matthew-wolf-n4mtt/audio-switch/hardware/mark-2b/tools/Pot-vol-drop.ods

Vin | Rin | Vout | V+ | V- |  | Vin | Rin | Vout | V+ |  | Drop V+ Side |  |  |  |  |  |  |  |  | Drop V- Side
2.2248 | 2200 | 0.0967304348 | 0.0483652174 | -0.0483652174 |  | 15 | 1000 | 6 | 3
Rg | 2300 | 0.0927 | 0.04635 | -0.04635 |  |  | 1500 | 7.5 | 3.75 |  | Add res between V+ and pot (Rpn) |  |  |  |  |  |  |  |  | Add res between V- and pot (Rpn)
1.00E+002 | 2400 | 0.088992 | 0.044496 | -0.044496 |  |  | 2000 | 8.5714285714 | 4.2857142857 |  | (V+) + abs(V-)/(POT_total) + Rp = Irs (current through series Res) |  |  |  |  |  |  |  |  | (V+) + abs(V-)/(POT_total) + Rn = Irs (current through series Res)
 | 2420 | 0.0882857143 | 0.0441428571 | -0.0441428571 |  |  | 2500 | 9.375 | 4.6875
 | 2500 | 0.0855692308 | 0.0427846154 | -0.0427846154 |  |  | 3000 | 10 | 5 |  | Irs * Rpn = Vdrop |  |  |  |  |  |  |  |  | Irs * Rpn = Vdrop
 | 2347 | 0.0909194933 | 0.0454597466 | -0.0454597466 |  |  | 3500 | 10.5 | 5.25
 | 2270 | 0.0938734177 | 0.0469367089 | -0.0469367089 |  |  | 4000 | 10.9090909091 | 5.4545454545 |  | (V+)- Vdrop = adj V+ |  |  |  |  |  |  |  |  | (V-) + Vdrop = adj V-
 | 33000 | 0.0067214502 | 0.0033607251 | -0.0033607251 |  |  | 4500 | 11.25 | 5.625
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
