matthew-wolf-n4mtt/audio-switch/hardware/mark-2b/tools/Pot-vol-out.ods

 | https://www.maximintegrated.com/en/app-notes/index.mvp/id/4288
Vh | 2.2448
Vl | -2.2448
Steps | 256
Vstep | 0.0176062745 |  | Vt= Vh – Vl / (steps-1)
Steps | Wiper Vol | Volt 23:1 Div | THAT2180 dB | Vout Ratio
0 | 2.2448 | 0.0976 | -16 | 0.1584893192
1 | 2.2271937255 | 0.0968345098 | -15.8745098039 | 0.1607957293
2 | 2.209587451 | 0.0960690196 | -15.7490196078 | 0.1631357033
3 | 2.1919811765 | 0.0953035294 | -15.6235294118 | 0.1655097297
4 | 2.174374902 | 0.0945380392 | -15.4980392157 | 0.167918304
5 | 2.1567686275 | 0.093772549 | -15.3725490196 | 0.170361929
6 | 2.1391623529 | 0.0930070588 | -15.2470588235 | 0.1728411148
7 | 2.1215560784 | 0.0922415686 | -15.1215686275 | 0.1753563789
8 | 2.1039498039 | 0.0914760784 | -14.9960784314 | 0.1779082462
9 | 2.0863435294 | 0.0907105882 | -14.8705882353 | 0.1804972495
10 | 2.0687372549 | 0.089945098 | -14.7450980392 | 0.1831239291
11 | 2.0511309804 | 0.0891796078 | -14.6196078431 | 0.1857888334
12 | 2.0335247059 | 0.0884141176 | -14.4941176471 | 0.1884925187
13 | 2.0159184314 | 0.0876486275 | -14.368627451 | 0.1912355492
14 | 1.9983121569 | 0.0868831373 | -14.2431372549 | 0.1940184976
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
