matthew-wolf-n4mtt/audio-switch/hardware/mark-2c/dac-desgin-validation/DAC-stuff.ods

AD5337 vout
Vref |  | DAC code | Vout | Scaled by Vdiv | Voff | dB offset v | Round
5 | 0 | 0 | 0.000000 | 0.000000 | 0.168000 | 27.540984 | 27.5 | 27.0 |  |  |  | -0.61 | 0.16775 |  |  | Voff | -0.61 | -0.000003427
R1 | 1 | 1 | 0.019608 | 0.003057 | 0.164943 | 27.039908 | 27 | 26.5
6.34E+003 | 2 | 2 | 0.039216 | 0.006113 | 0.161887 | 26.538832 | 26.5 |  |  |  |  |  | V: | -0.16775 | 0.61
R2 | 3 | 3 | 0.058824 | 0.009170 | 0.158830 | 26.037757 | 26 |  |  |  |  |  | dB: | 27.5 | -100
6.49E+003 | 4 | 4 | 0.078431 | 0.012226 | 0.155774 | 25.536681 | 25.5
R3 | 5 | 5 | 0.098039 | 0.015283 | 0.152717 | 25.035605 | 25 |  |  |  |  |  | V: | 0.16513 | -0.60795
2.00E+003 | 6 | 6 | 0.117647 | 0.018339 | 0.149661 | 24.534530 | 24.5 |  |  |  |  |  | dB: | 27.0704918033 | -99.6639344262
Roffset | 7 | 7 | 0.137255 | 0.021396 | 0.146604 | 24.033454 | 24
1.78E+005 | 8 | 8 | 0.156863 | 0.024452 | 0.143548 | 23.532378 | 23.5 |  |  | Low | mid | high
Voffset | 9 | 9 | 0.176471 | 0.027509 | 0.140491 | 23.031302 | 23 |  | 0 | 0.164898 | -0.22044 | -0.60847
0.168 | A | 10 | 0.196078 | 0.030566 | 0.137434 | 22.530227 | 22.5 |  | 1 | 0.166065 | -0.22045 | -0.60696
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
