matthew-wolf-n4mtt/audio-switch/hardware/mark-2c/add-lpf-vga-to-audio-switch-0_2.pdf

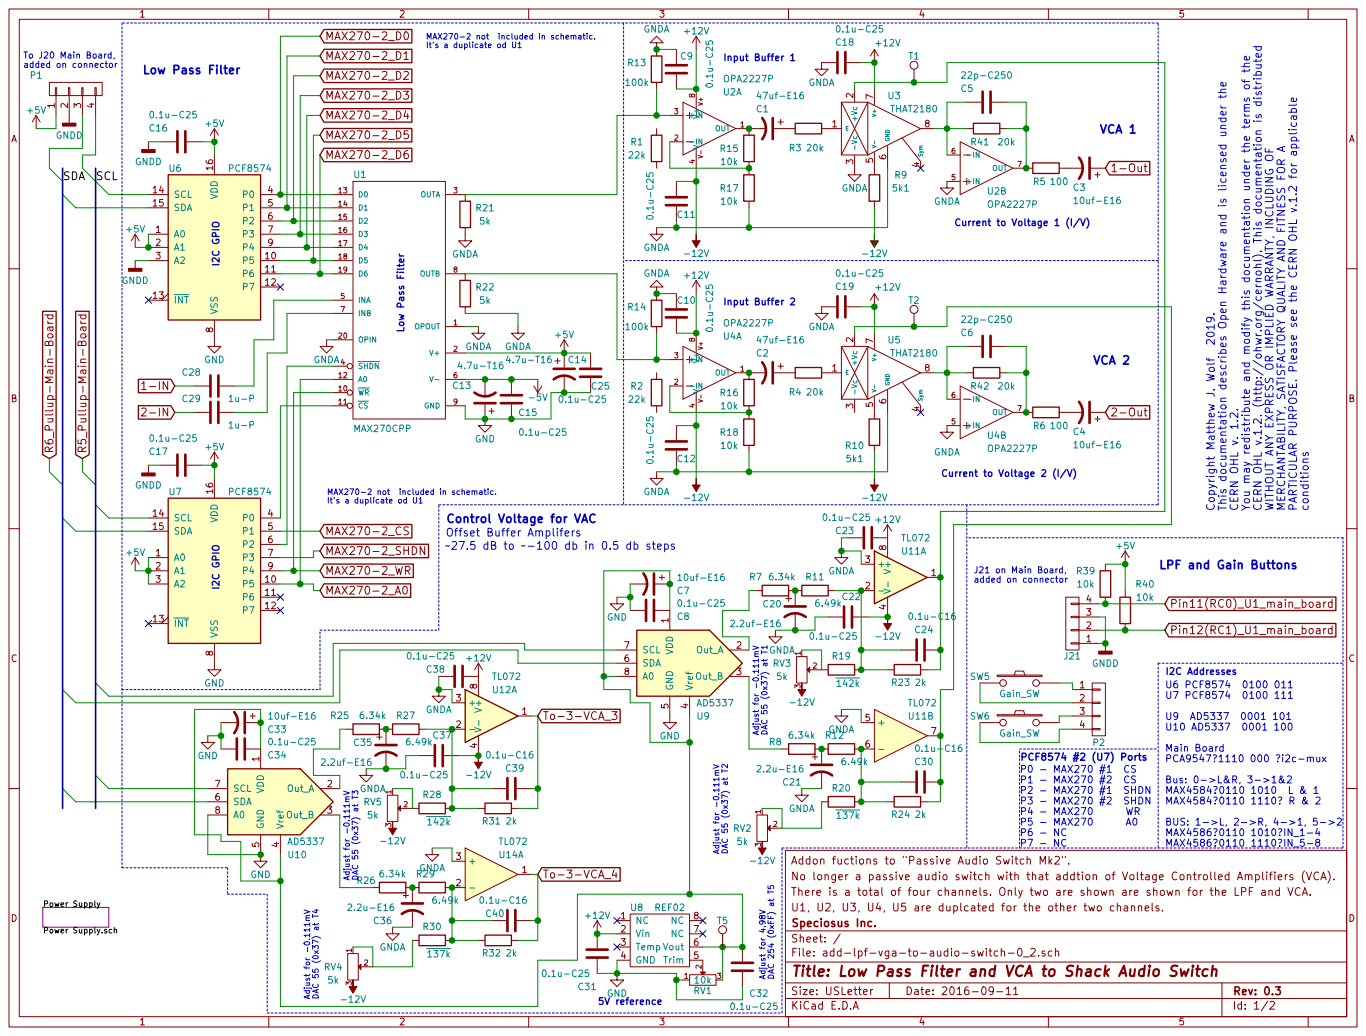
[picture p1: page 1]

T2T1 MAX270-2 not included in schematic.

4 P1 To J20 Main Board, added on connector +5V GNDD

VCA 2 Low Pass FilterI2C GPIO I2C GPIO

Control Voltage for VAC
Offset Buffer Amplifers
27.5 dB to -100 db in 0.5 db steps

J21 on Main Board, added on connector

No longer a passive audio switch with that addtion of Voltage Controlled Amplifiers (VCA). Addon fuctions to "Passive Audio Switch Mk2".

There is a total of four channels. Only two are shown are shown for the LPF and VCA.
U1, U2, U3, U4, U5 are duplcated for the other two channels.
D Date: 2016-09-11 KiCad E.D.A
File: add-lpf-vga-to-audio-switch-0_2.sch Sheet: / Speciosus Inc.

Id: 1/2 Title: Low Pass Filter and VCA to Shack Audio Switch

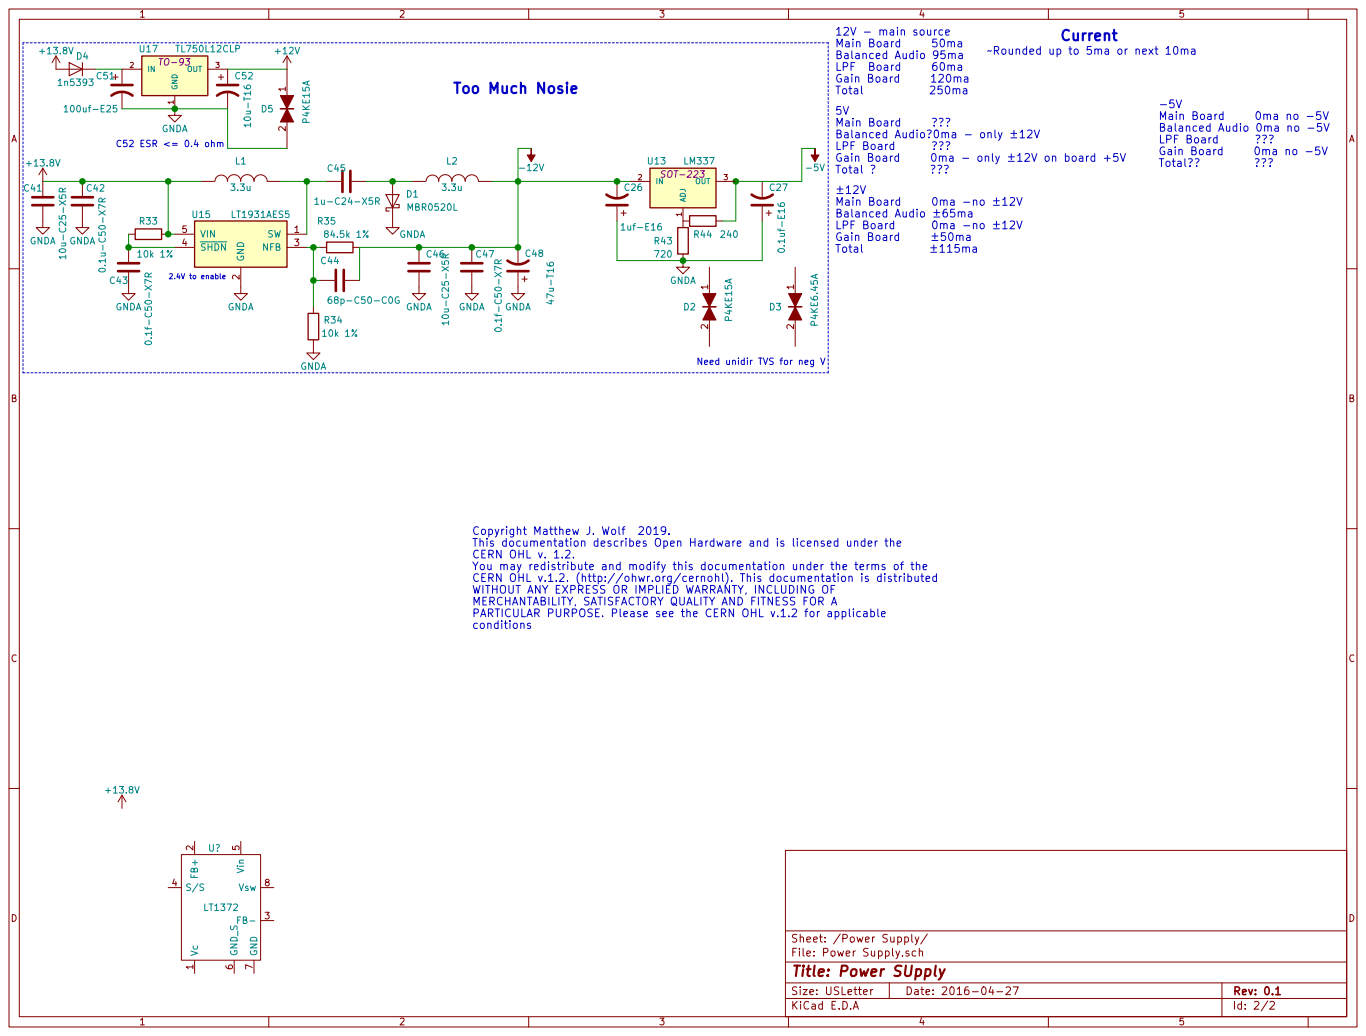
[picture p2: page 2]

1 2 D2 P4KE15A1 2 D3 P4KE6.45A2.4V to enable Current 5VMain Board ??? Balanced Audio 0ma - only ±12V

Copyright Matthew J. Wolf 2019.
This documentation describes Open Hardware and is licensed under the CERN OHL v. 1.2. You may redistribute and modify this documentation under the terms of the

CERN OHL v.1.2. (http://ohwr.org/cernohl). This documentation is distributed
WITHOUT ANY EXPRESS OR IMPLIED WARRANTY, INCLUDING OF
MERCHANTABILITY, SATISFACTORY QUALITY AND FITNESS FOR A
PARTICULAR PURPOSE. Please see the CERN OHL v.1.2 for applicable
conditions

D Date: 2016-04-27 KiCad E.D.A

Sheet: /Power Supply/
File: Power Supply.sch
Id: 2/2 Title: Power SUpply

Size: USLetter | | Rev: 0.1
