matthew-wolf-n4mtt/audio-switch/hardware/mark-2a/unbalanced to balanced line driver.pdf

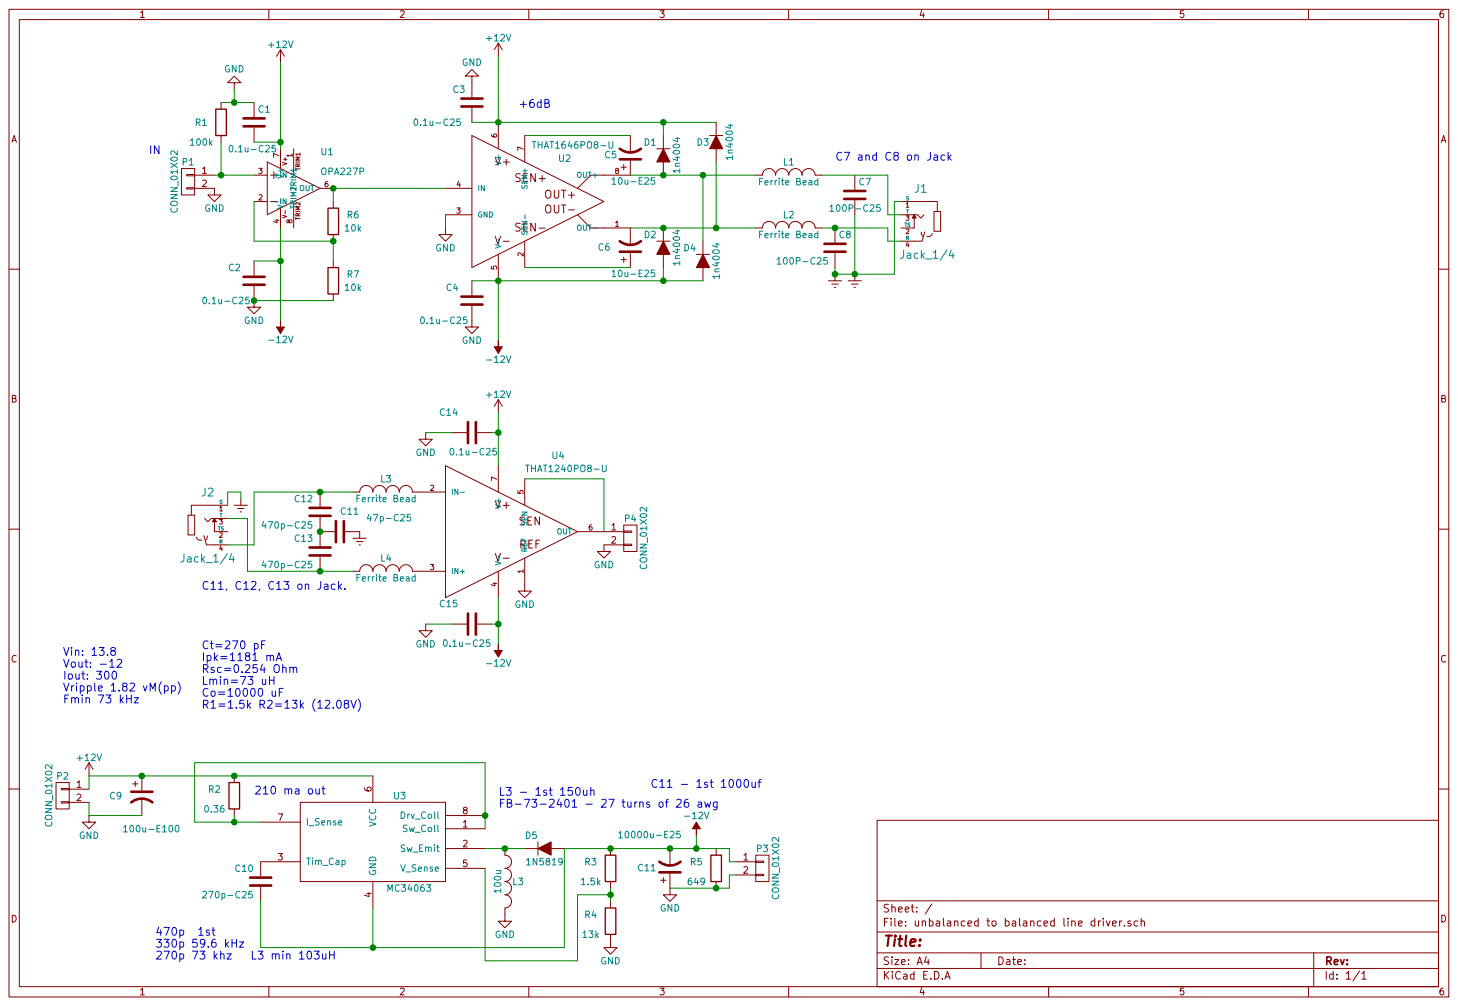
[picture p3: page 1]

L3 - 1st 150uh FB-73-2401 - 27 turns of 26 awg

Id: 1/1 Title: File: unbalanced to balanced line driver.sch Sheet: /
D Date: KiCad E.D.A
