matthew-wolf-n4mtt/audio-switch/hardware/mark-2b/add-lpf-vga-to-audio-switch.pdf

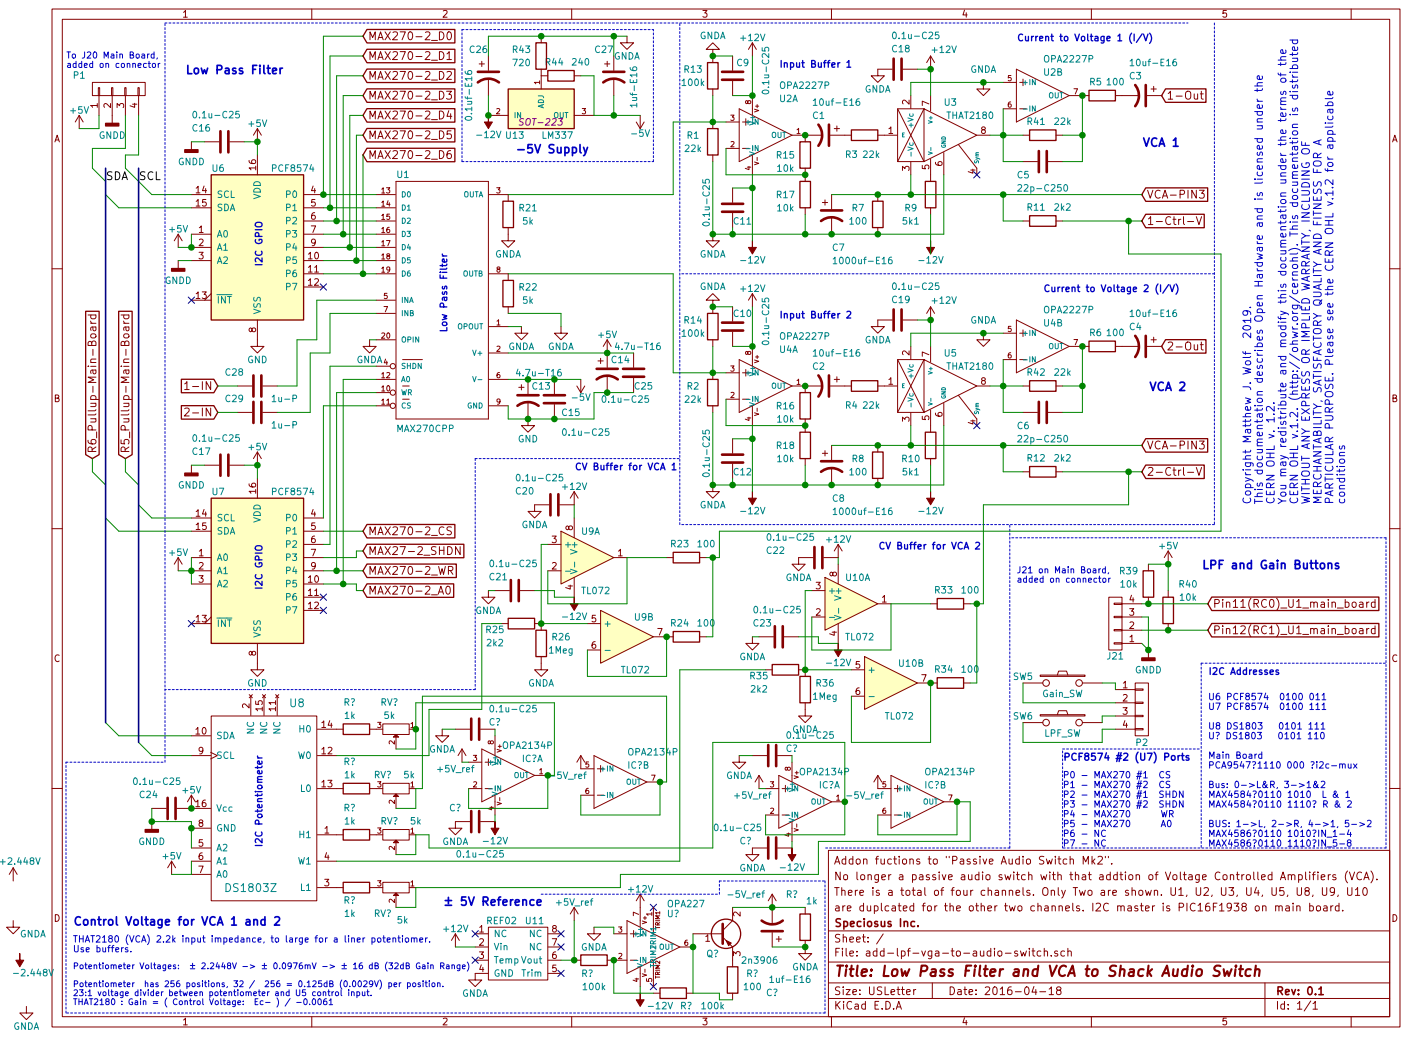
[picture p4: page 1]

4 P1 To J20 Main Board, added on connector +5V GNDD

J21 on Main Board, added on connector

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

There is a total of four channels. Only Two are shown. U1, U2, U3, U4, U5, U8, U9, U10
are duplcated for the other two channels. I2C master is PIC16F1938 on main board.
D Date: 2016-04-18 KiCad E.D.A
File: add-lpf-vga-to-audio-switch.sch Sheet: / Speciosus Inc.

Id: 1/1 Title: Low Pass Filter and VCA to Shack Audio Switch
