matthew-wolf-n4mtt/audio-switch/hardware/mark-3/Audio-Switch-Hardware-MK3.pdf

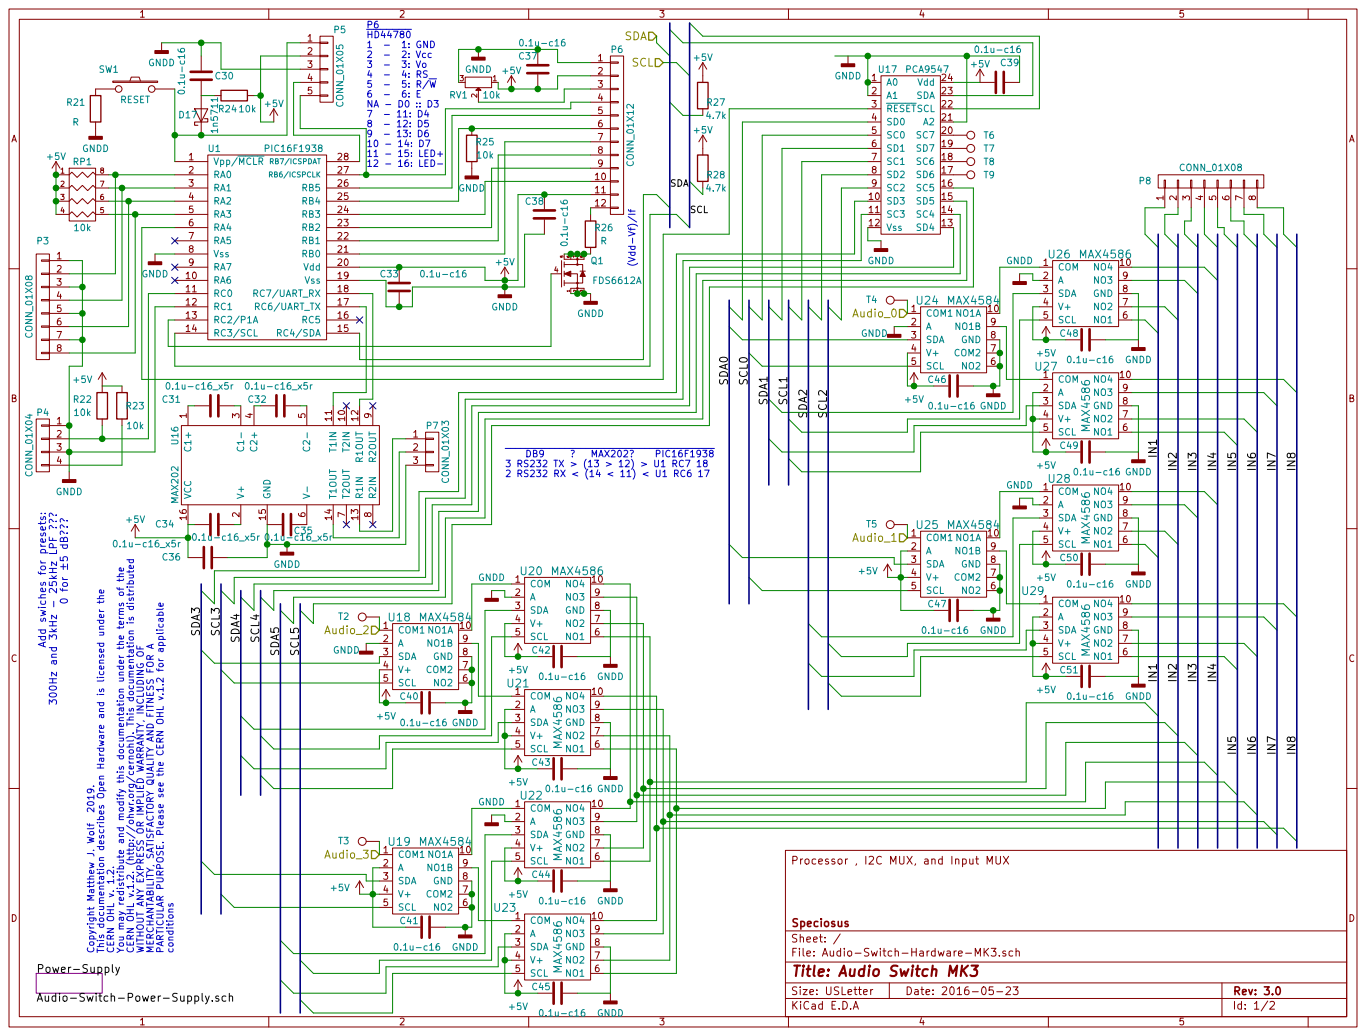
[picture p5: page 1]

SCL Copyright Matthew J. Wolf 2019. This documentation describes Open Hardware and is licensed under the CERN OHL v. 1.2. You may redistribute and modify this documentation under the terms of the CERN OHL v.1.2. (http://ohwr.org/cernohl). This documentation is distributed WITHOUT ANY EXPRESS OR IMPLIED WARRANTY, INCLUDING OF MERCHANTABILITY, SATISFACTORY QUALITY AND FITNESS FOR A PARTICULAR PURPOSE. Please see the CERN OHL v.1.2 for applicable conditions

8 Q1FDS6612A GNDD Add swiches for presets: 300Hz and 3kHz - 25kHz LPF ??? 0 for ±5 dB??? R22

Processor , I2C MUX, and Input MUX

D Date: 2016-05-23 KiCad E.D.A
File: Audio-Switch-Hardware-MK3.sch Sheet: / Speciosus

Id: 1/2 Title: Audio Switch MK3

Audio-Switch-Power-Supply.sch

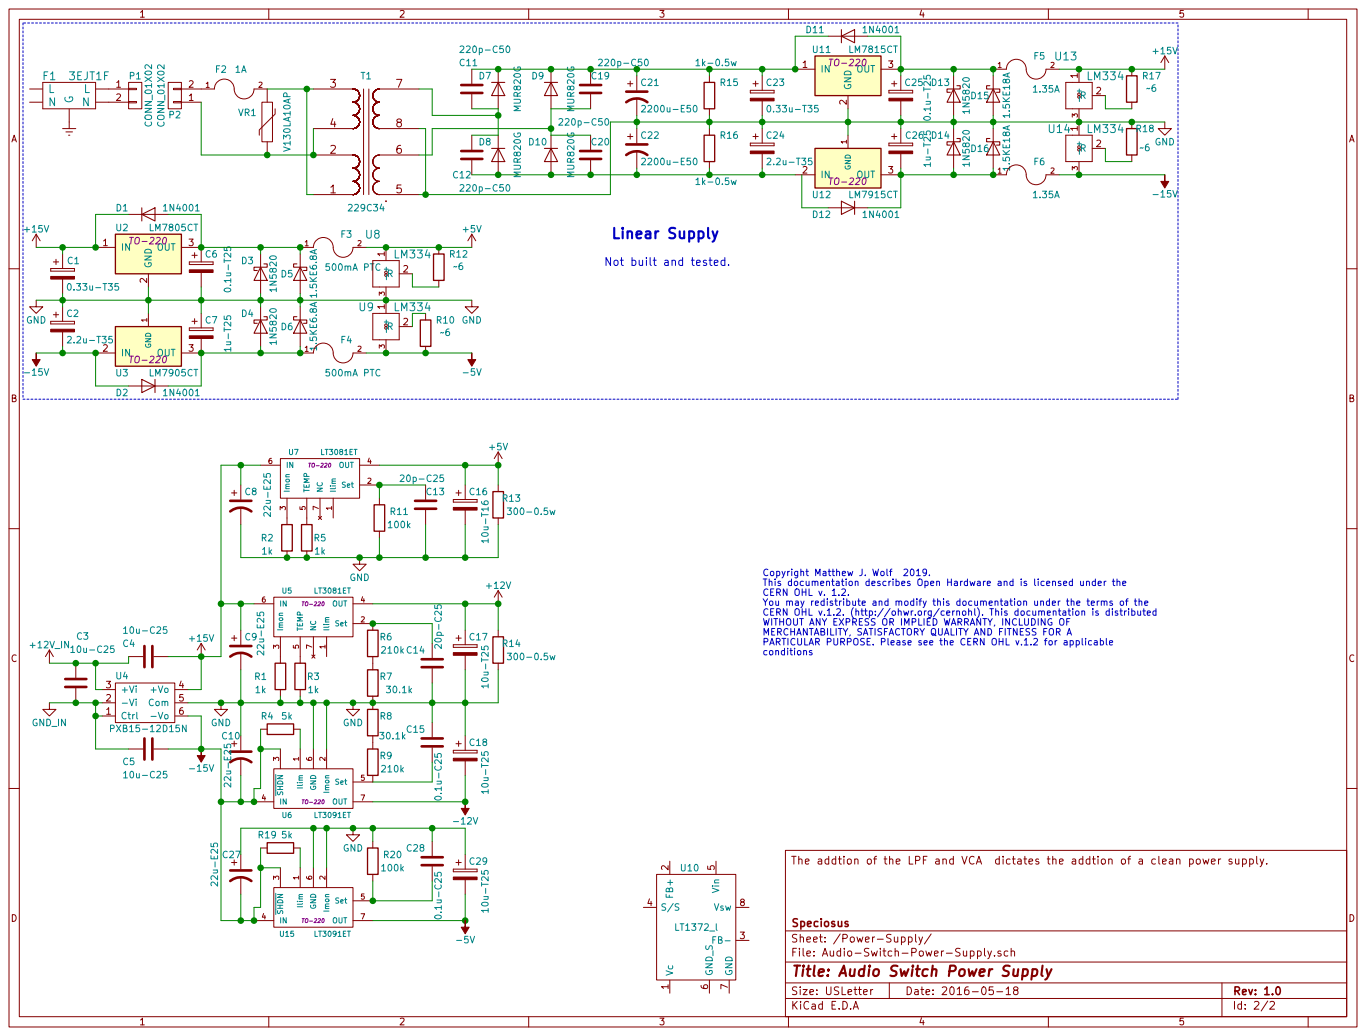
[picture p6: page 2]
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

PARTICULAR PURPOSE. Please see the CERN OHL v.1.2 for applicable
conditions

D Date: 2016-05-18 KiCad E.D.A

Speciosus
Sheet: /Power-Supply/
File: Audio-Switch-Power-Supply.sch
Id: 2/2 Title: Audio Switch Power Supply

Size: USLetter | | Rev: 1.0
