matthew-wolf-n4mtt/audio-switch/hardware/mark-0/audio-switch-MK0-all.pdf

PIC16F1938 | U1

U2

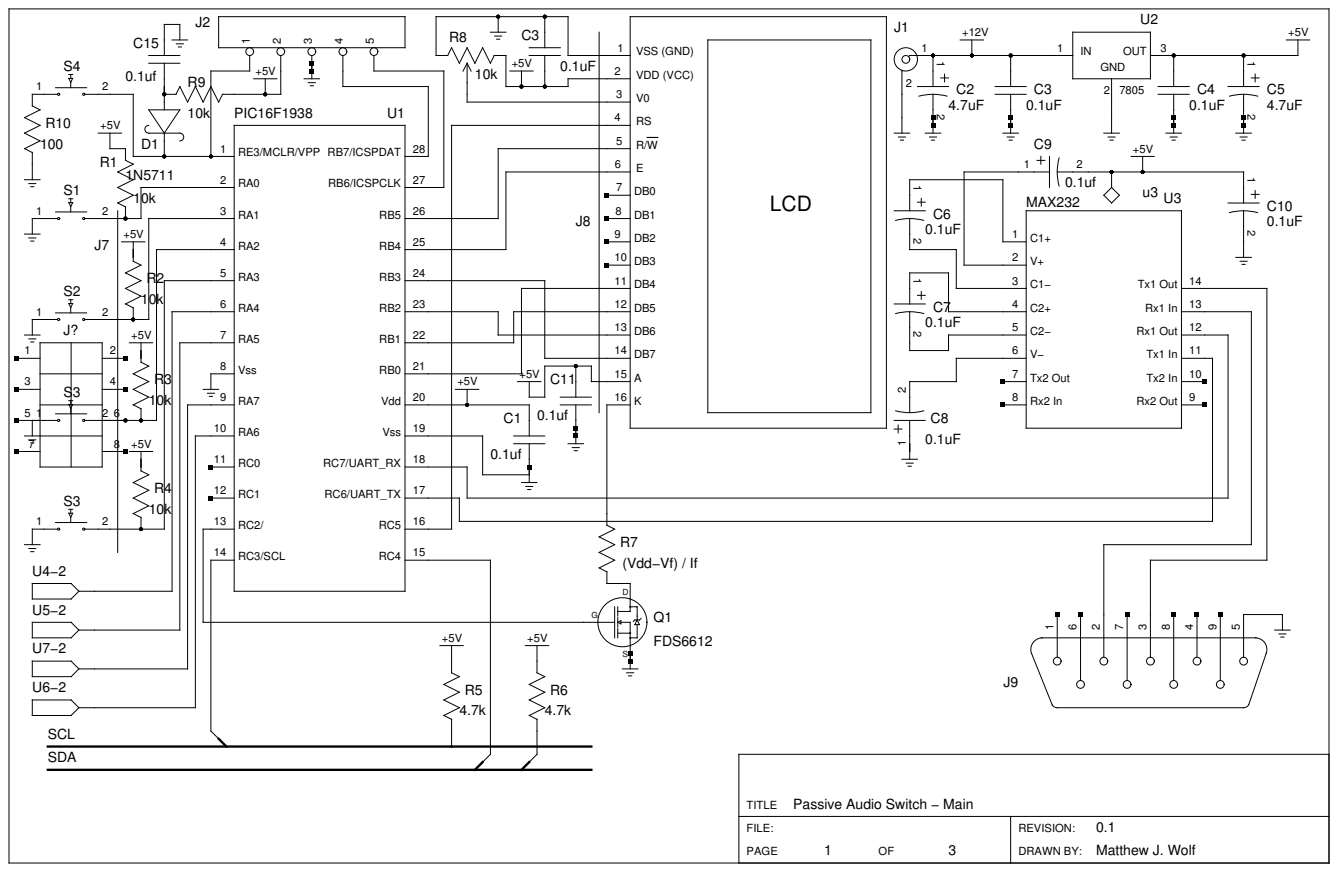
[picture p7: page 1]

Passive Audio Switch − Main

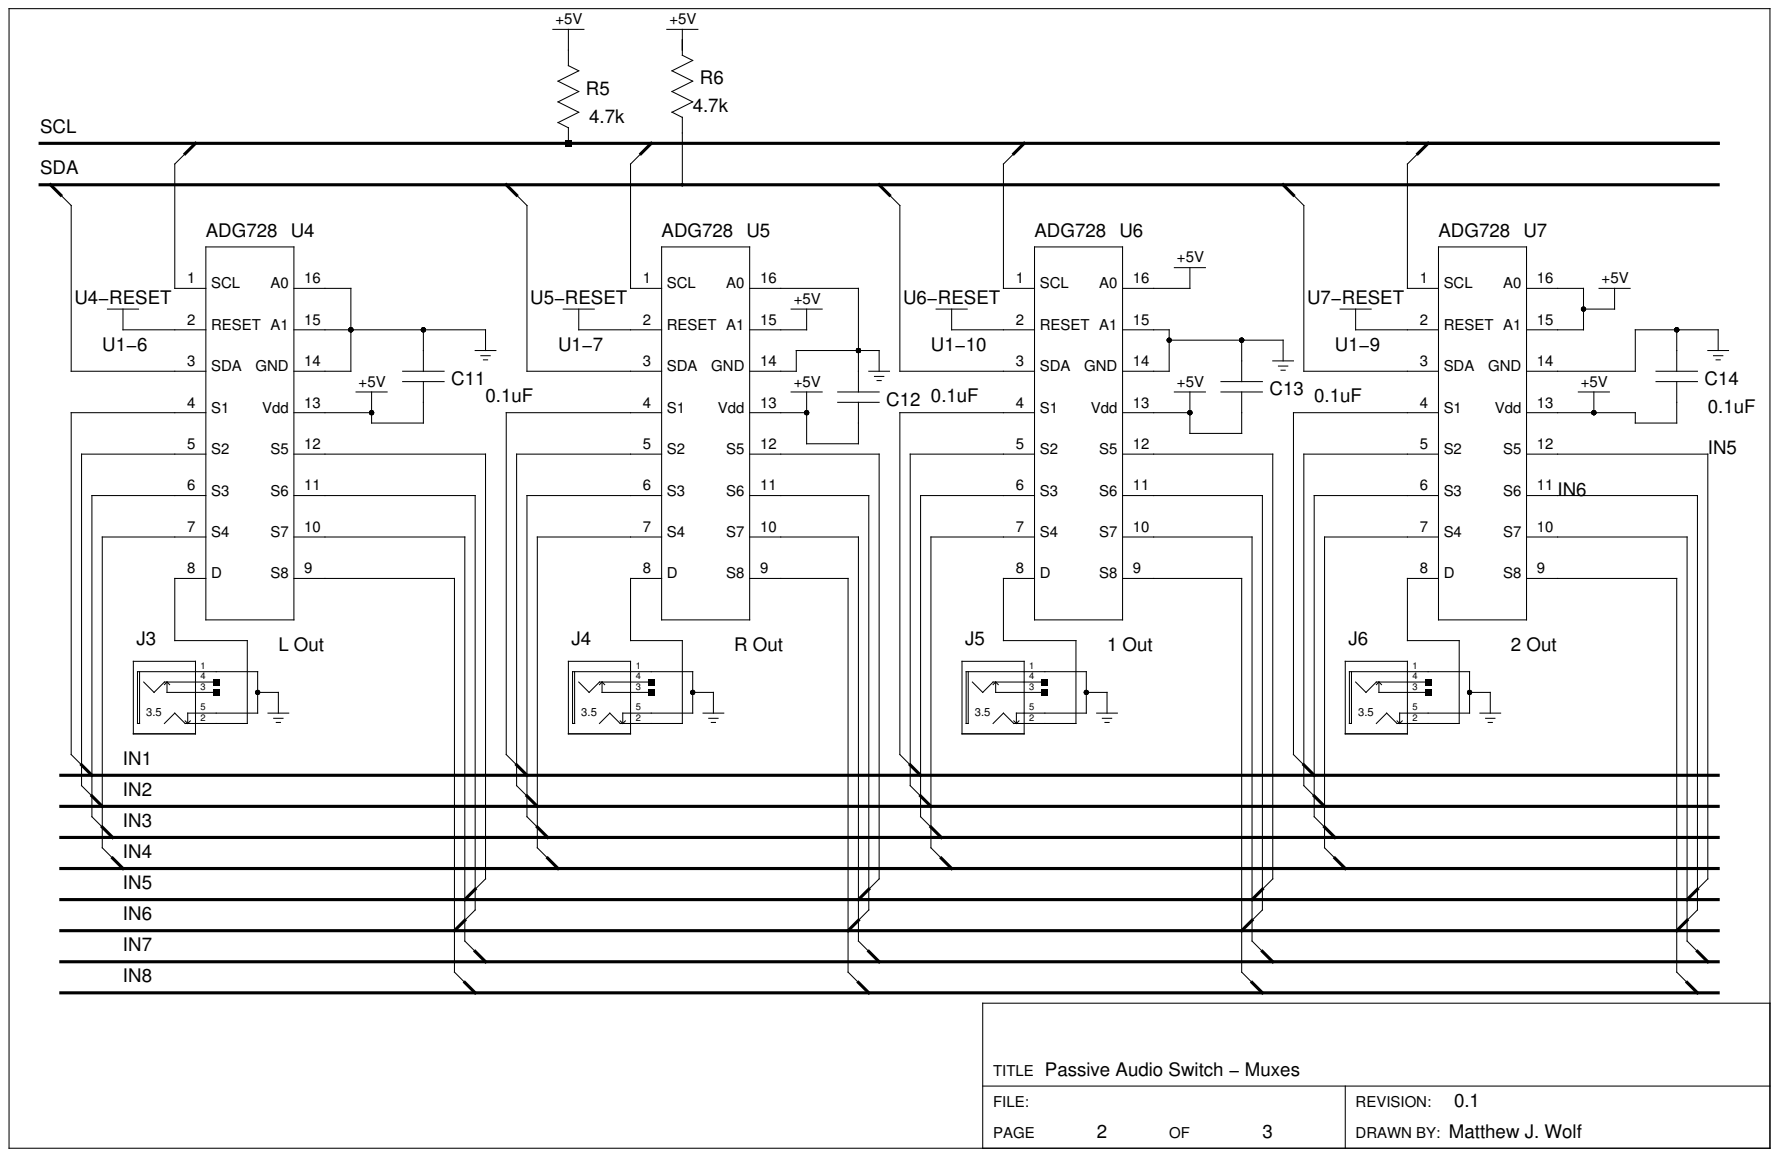
[picture p8: page 2]

Passive Audio Switch − Muxes

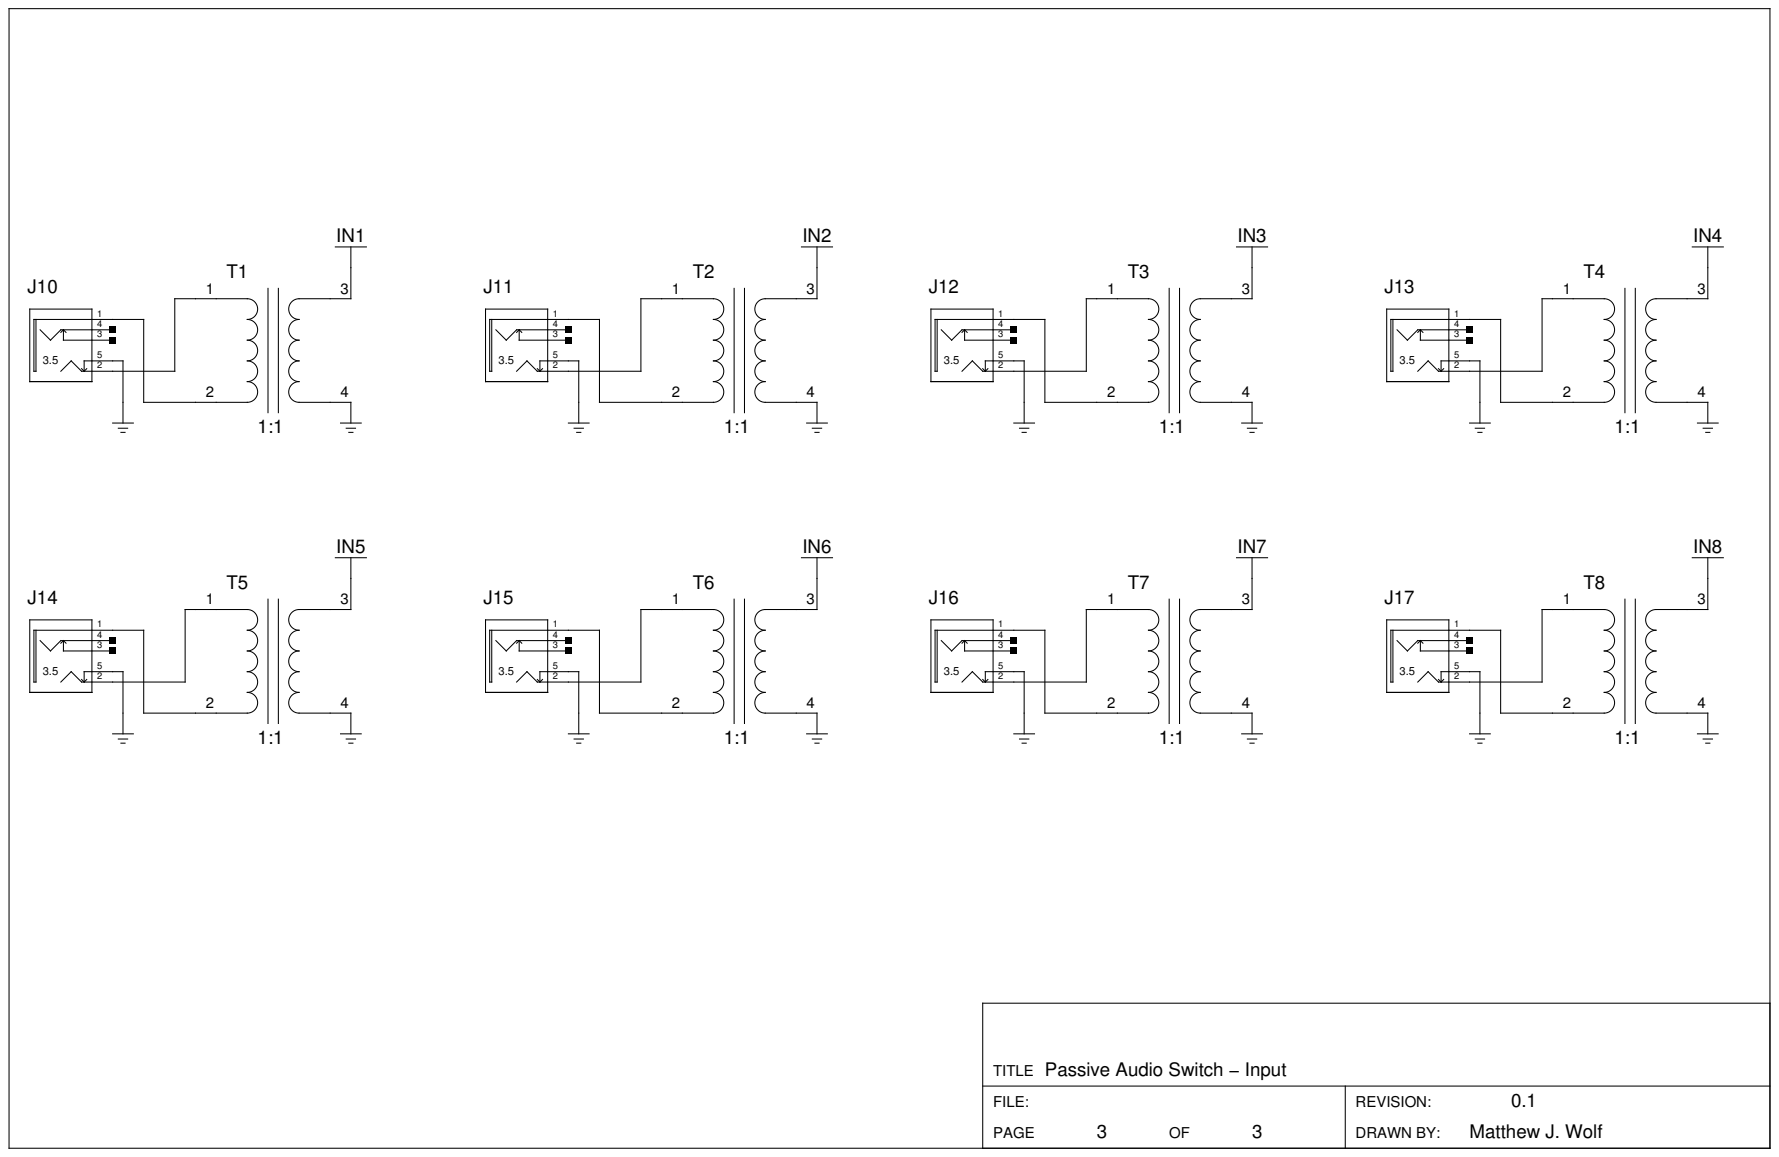
[picture p9: page 3]

Passive Audio Switch − Input
