matthew-wolf-n4mtt/audio-switch/hardware/mark-1/audio-switch-MK1-all.pdf

PIC16F1938 | U1

U2

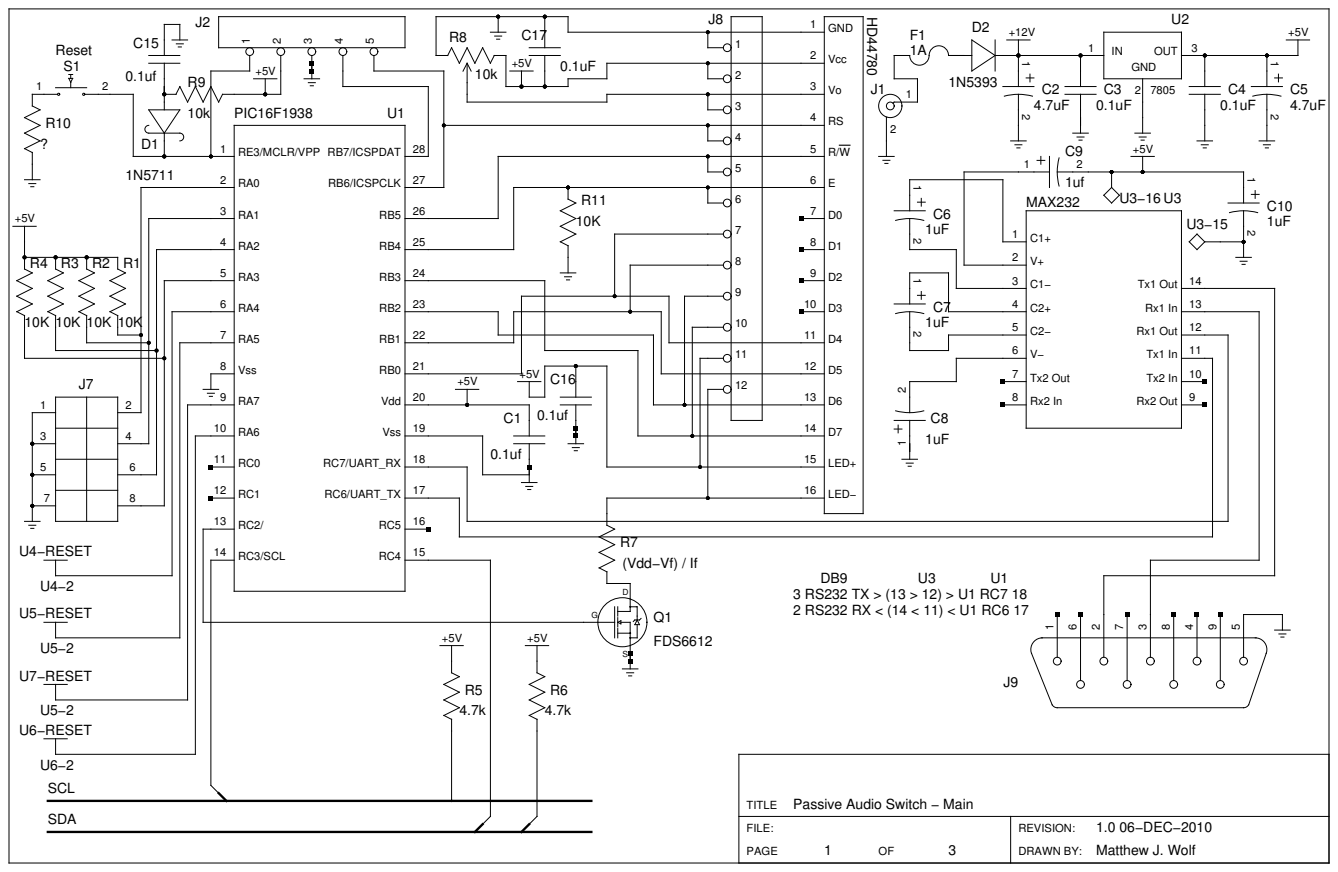
[picture p10: page 1]

Passive Audio Switch − Main


Passive Audio Switch − Muxes

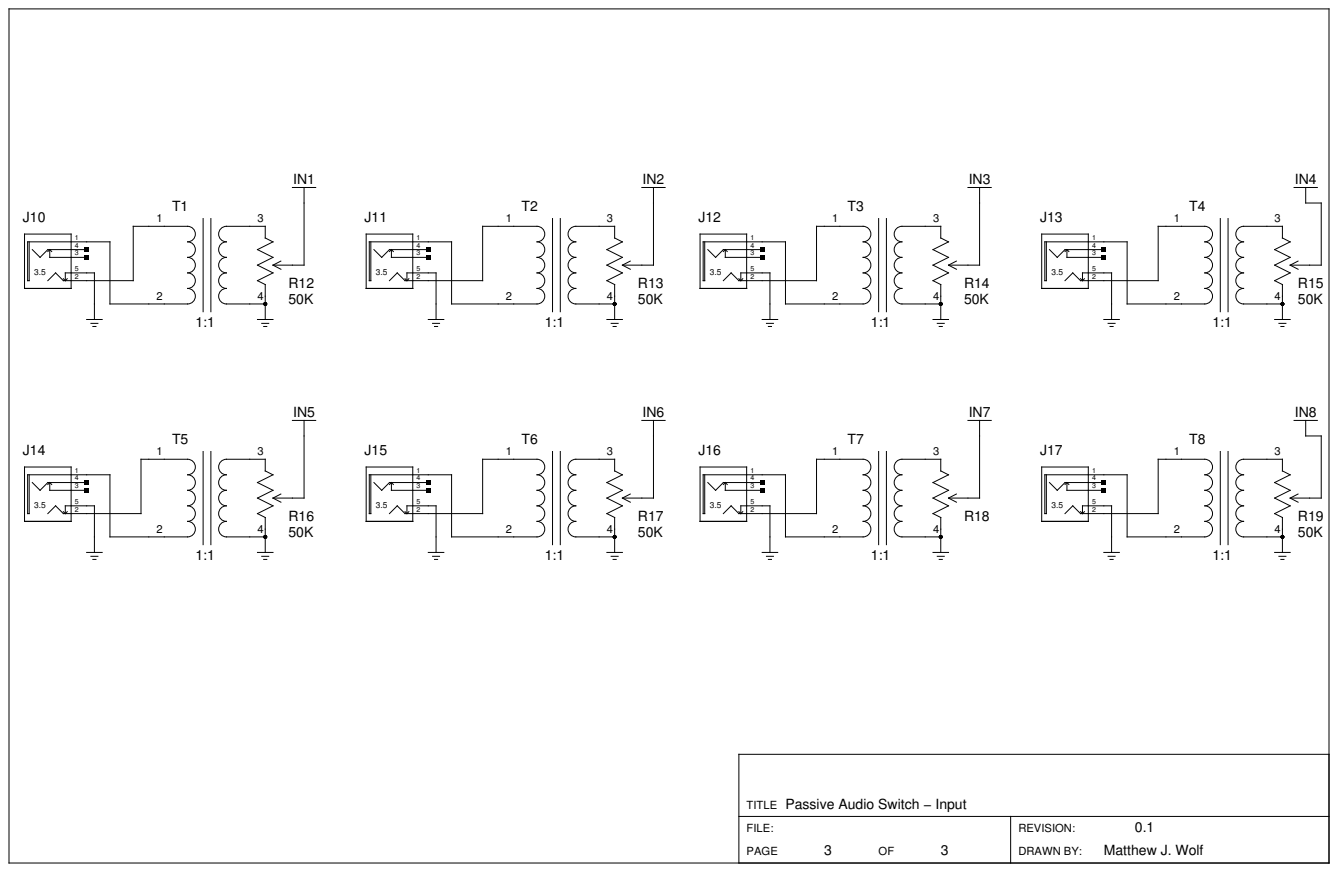
[picture p11: page 3]

Passive Audio Switch − Input
