matthew-wolf-n4mtt/audio-switch/hardware/mark-2/audio-switch-MK2-all.pdf

PIC16F1938 | U1

U2

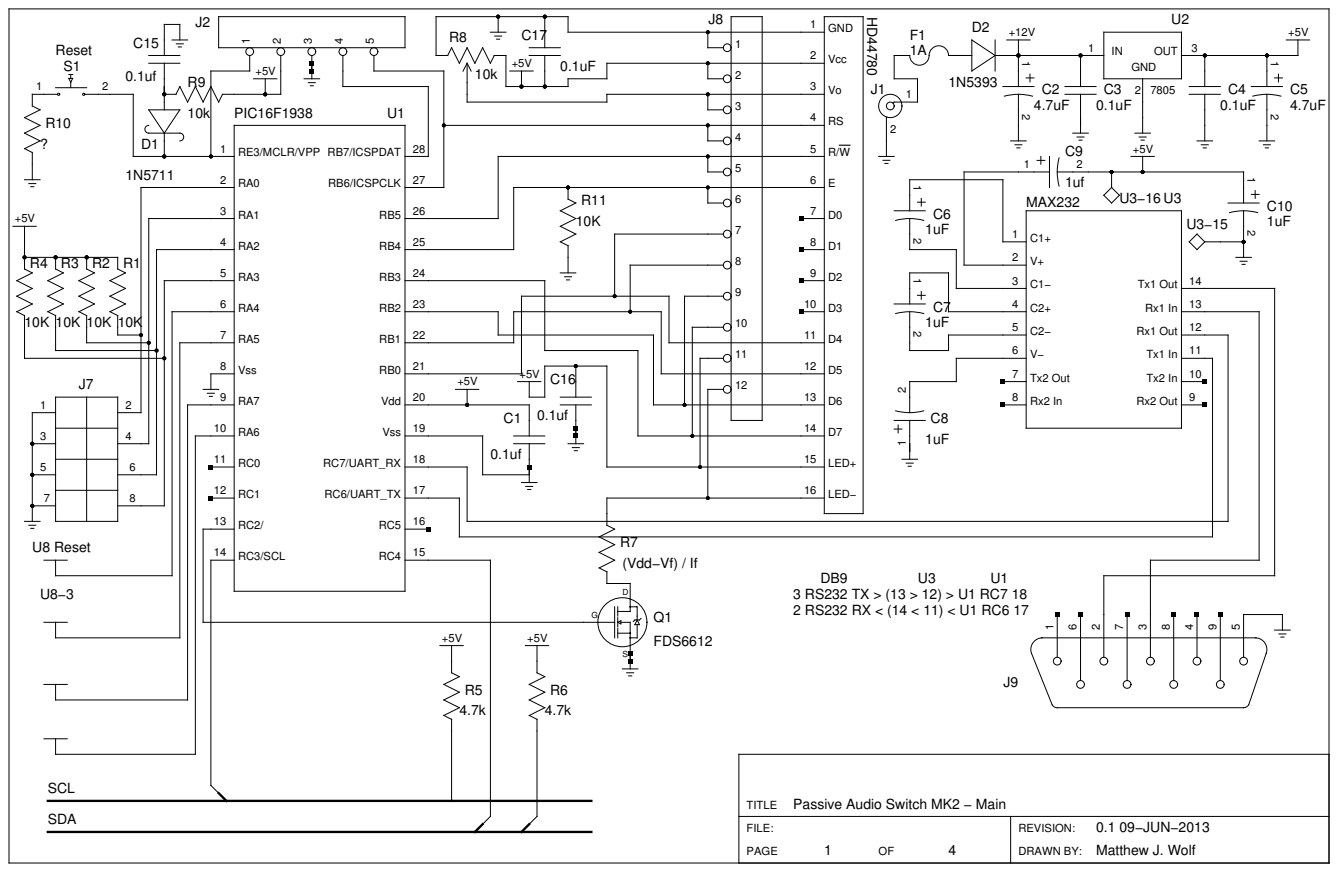
[picture p12: page 1]

Passive Audio Switch MK2 − Main

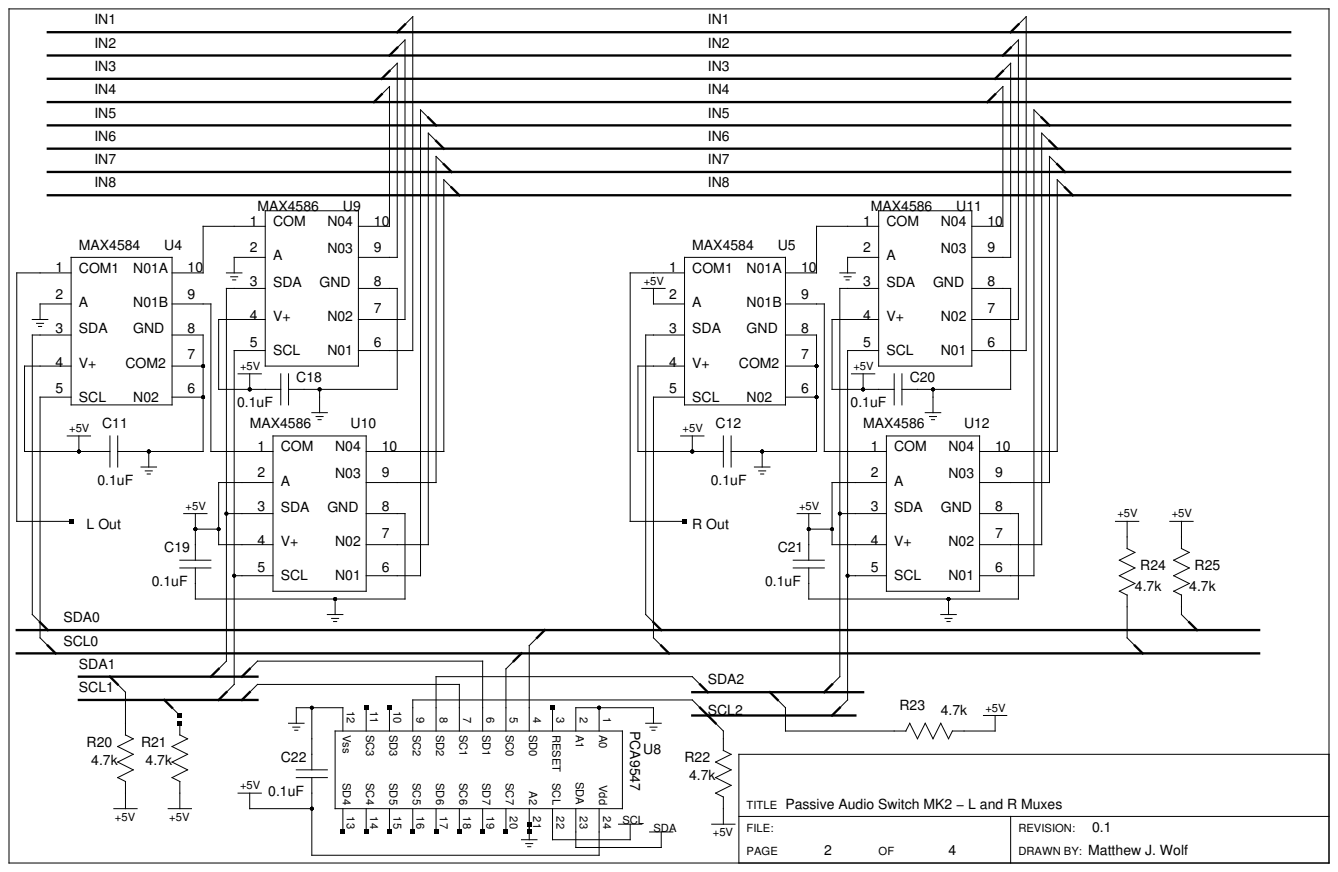
[picture p13: page 2]

Passive Audio Switch MK2 − L and R Muxes

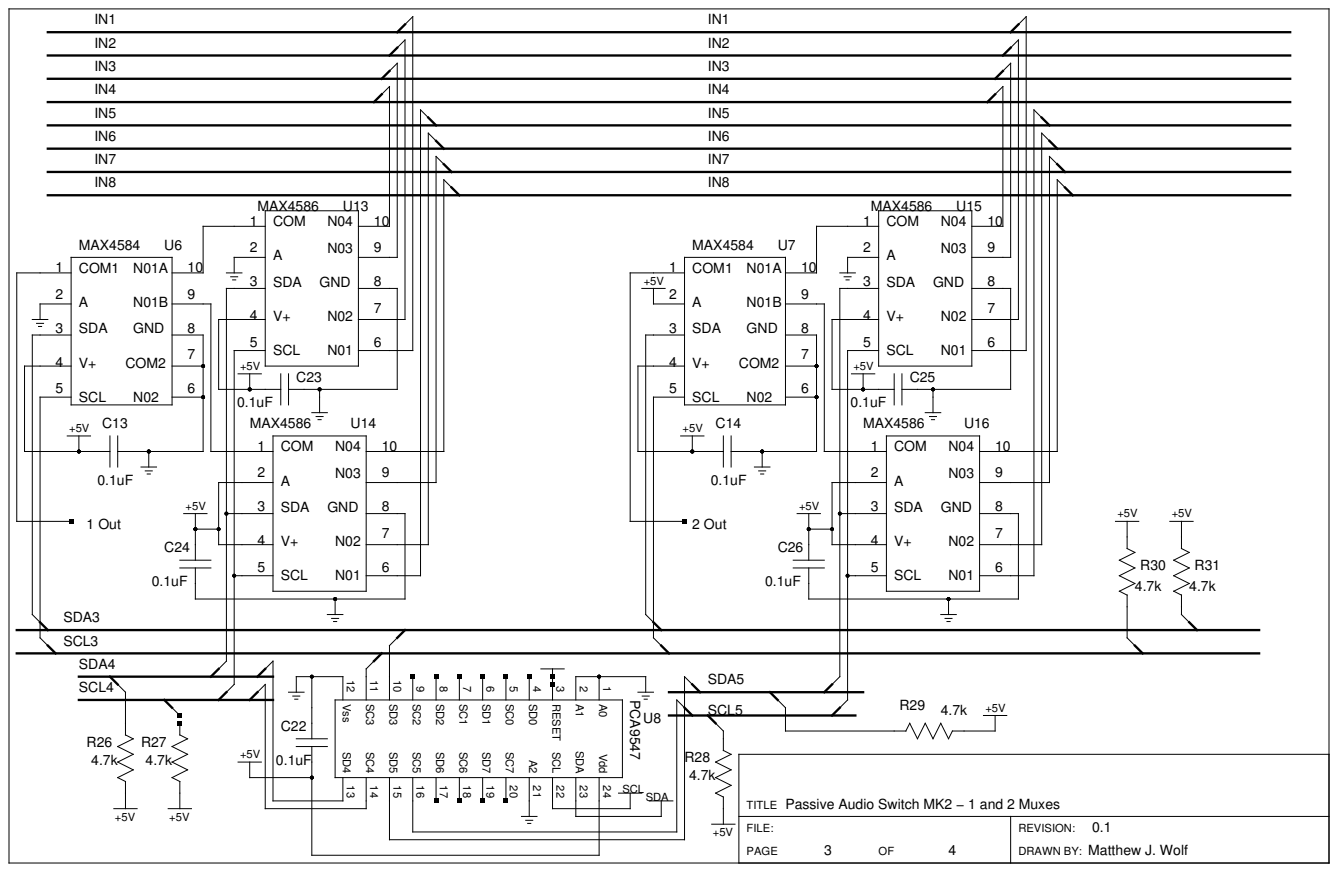
[picture p14: page 3]

Passive Audio Switch MK2 − 1 and 2 Muxes

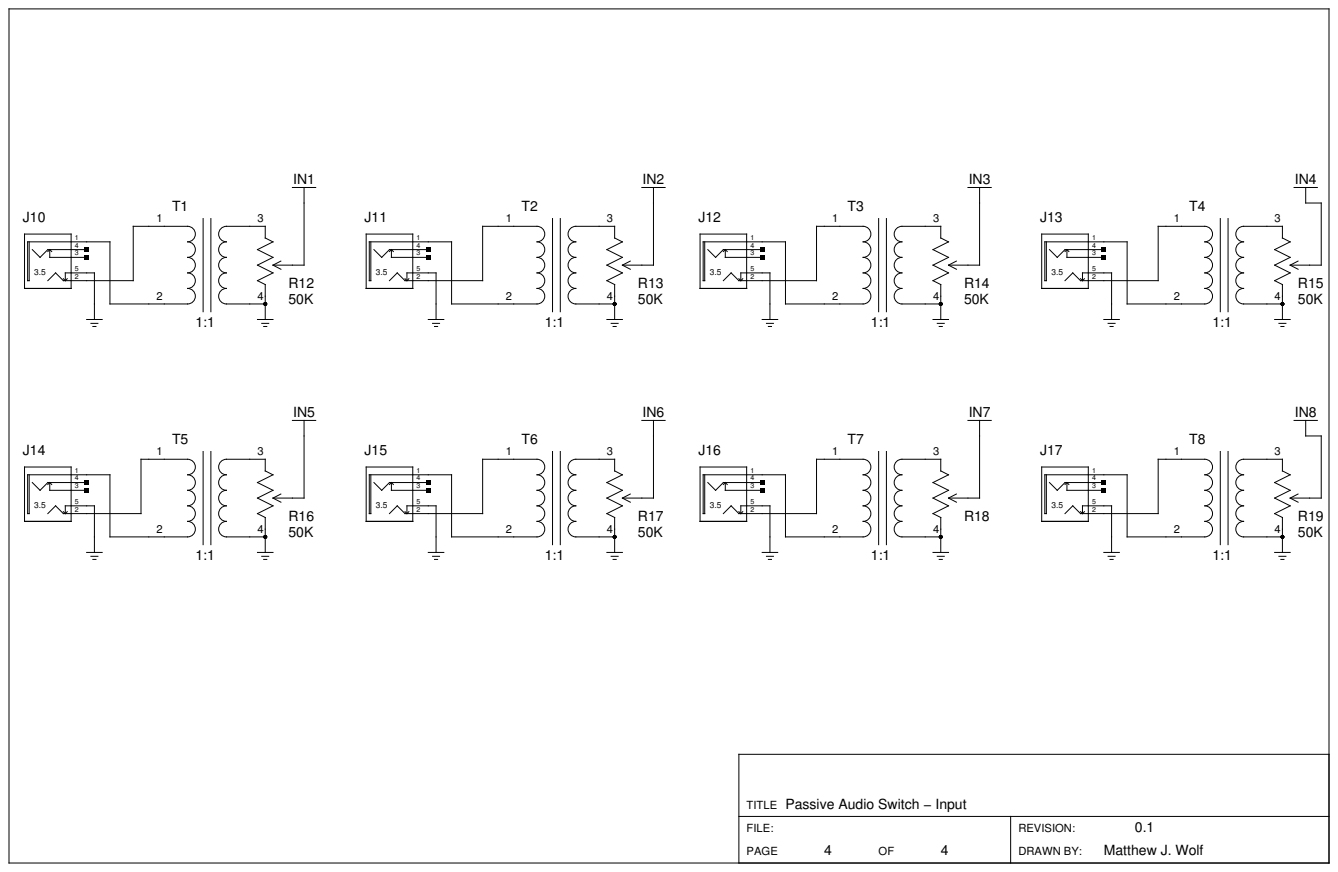
[picture p15: page 4]

Passive Audio Switch − Input
