matthew-wolf-n4mtt/audio-switch/firmware/mark-4_1/DisGain.asm

; DisGain.asm
; Version: 4.1
; Author:  Matthew J. Wolf
; Date:    01-MAY-2016, Info added 16-SEP-2019
;  
; This file is part of the Audio-Switch-MK4.
; By Matthew J. Wolf <matthew.wolf@speciosus.net>
; Copyright 2019 Matthew J. Wolf
;
; The Audio-Switch is distributed in the hope that
; it will be useful, but WITHOUT ANY WARRANTY; without even the implied
; warranty of MERCHANTABILITY or FITNESS FOR A PARTICULAR PURPOSE.  See
; the GNU General Public License for more details.
;
; You should have received a copy of the GNU General Public License
; along with the Audio-Switch-MK4.
; If not, see <http://www.gnu.org/licenses/>.
;
    title		'DisGain - Display Gain lines LCD display'
    subtitle	''
    list		b=4,c=132,n=77,x=Off

; ------------------------------------------------------------------------
;**
;  DisLCD
;  Displayes Gain line on the LCD.
;
;  Uses the LCDlib from the Elmer 160.
;**
;
; N4MTT - 26-March-2016
; $Revision 1.0	$Date: 2016-03-26 01441:00 $


    include		p16f1938.inc
			;include		p16f1933.inc

    global		DisGain,SerMessCommGain
    extern		LCDletr
    extern		SerialSendChar


    udata
GainCharIdx	res			1	; Counter for name char index
GainIdx		res			1

				;dt		"-10dB",0

.DisGain			code

DisGain
    banksel		GainIdx
    movwf		GainIdx
    clrf		GainCharIdx

DisGainS
    bcf			STATUS,Z		; Reset Status reg
    pagesel		Gain0Value
    movf		GainIdx,W
    xorlw		H'00'
    btfsc		STATUS,Z		 ;Was it Zero?
    goto		Gain0Value
    pagesel		Gain1ValueT
    movf		GainIdx,W
    xorlw		H'01'
    btfsc		STATUS,Z		 ;Was it Zero?
    goto		Gain1ValueT
    pagesel		Gain2ValueT
    movf		GainIdx,W
    xorlw		H'02'
    btfsc		STATUS,Z		 ;Was it Zero?
    goto		Gain2ValueT
    pagesel		Gain3ValueT
    movf		GainIdx,W
    xorlw		H'03'
    btfsc		STATUS,Z		 ;Was it Zero?
    goto		Gain3ValueT
    pagesel		Gain4ValueT
    movf		GainIdx,W
    xorlw		H'04'
    btfsc		STATUS,Z		 ;Was it Zero?
    goto		Gain4ValueT
    pagesel		Gain5ValueT
    movf		GainIdx,W
    xorlw		H'05'
    btfsc		STATUS,Z		 ;Was it Zero?
    goto		Gain5ValueT
    pagesel		Gain6ValueT
    movf		GainIdx,W
    xorlw		H'06'
    btfsc		STATUS,Z		 ;Was it Zero?
    goto		Gain6ValueT
    pagesel		Gain7ValueT
    movf		GainIdx,W
    xorlw		H'07'
    btfsc		STATUS,Z		 ;Was it Zero?
    goto		Gain7ValueT
    pagesel		Gain8ValueT
    movf		GainIdx,W
    xorlw		H'08'
    btfsc		STATUS,Z		 ;Was it Zero?
    goto		Gain8ValueT
    pagesel		Gain9ValueT
    movf		GainIdx,W
    xorlw		H'09'
    btfsc		STATUS,Z		 ;Was it Zero?
    goto		Gain9ValueT
    pagesel		Gain10ValueT
    movf		GainIdx,W
    xorlw		H'0A'
    btfsc		STATUS,Z		 ;Was it Zero?
    goto		Gain10ValueT
    pagesel		Gain11ValueT
    movf		GainIdx,W
    xorlw		H'0B'
    btfsc		STATUS,Z		 ;Was it Zero?
    goto		Gain11ValueT
    pagesel		Gain12ValueT
    movf		GainIdx,W
    xorlw		H'0C'
    btfsc		STATUS,Z		 ;Was it Zero?
    goto		Gain12ValueT
    pagesel		Gain13ValueT
    movf		GainIdx,W
    xorlw		H'0D'
    btfsc		STATUS,Z		 ;Was it Zero?
    goto		Gain13ValueT
    pagesel		Gain14ValueT
    movf		GainIdx,W
    xorlw		H'0E'
    btfsc		STATUS,Z		 ;Was it Zero?
    goto		Gain14ValueT
    pagesel		Gain15ValueT
    movf		GainIdx,W
    xorlw		H'0F'
    btfsc		STATUS,Z		 ;Was it Zero?
    goto		Gain15ValueT
    pagesel		Gain16ValueT
    movf		GainIdx,W
    xorlw		H'10'
    btfsc		STATUS,Z		 ;Was it Zero?
    goto		Gain16ValueT
    pagesel		Gain17ValueT
    movf		GainIdx,W
    xorlw		H'11'
    btfsc		STATUS,Z		 ;Was it Zero?
    goto		Gain17ValueT
    pagesel		Gain18ValueT
    movf		GainIdx,W
    xorlw		H'12'
    btfsc		STATUS,Z		 ;Was it Zero?
    goto		Gain18ValueT
    pagesel		Gain19ValueT
    movf		GainIdx,W
    xorlw		H'13'
    btfsc		STATUS,Z		 ;Was it Zero?
    goto		Gain19ValueT
    pagesel		Gain20ValueT
    movf		GainIdx,W
    xorlw		H'14'
    btfsc		STATUS,Z		 ;Was it Zero?
    goto		Gain20ValueT
    pagesel		Gain21ValueT
    movf		GainIdx,W
    xorlw		H'15'
    btfsc		STATUS,Z		 ;Was it Zero?
    goto		Gain21ValueT
    pagesel		Gain22ValueT
    movf		GainIdx,W
    xorlw		H'16'
    btfsc		STATUS,Z		 ;Was it Zero?
    goto		Gain22ValueT
    pagesel		Gain23ValueT
    movf		GainIdx,W
    xorlw		H'17'
    btfsc		STATUS,Z		 ;Was it Zero?
    goto		Gain23ValueT
    pagesel		Gain24ValueT
    movf		GainIdx,W
    xorlw		H'18'
    btfsc		STATUS,Z		 ;Was it Zero?
    goto		Gain24ValueT
    pagesel		Gain25ValueT
    movf		GainIdx,W
    xorlw		H'19'
    btfsc		STATUS,Z		 ;Was it Zero?
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
    xorlw		H'00'			; Test to see if char is Zero
    btfsc		STATUS,Z		; Was it Zero?
    return
    pagesel		LCDletr
    call		LCDletr			; Display Chr on LCD
    banksel		GainCharIdx
    incf		GainCharIdx,F		; Point to the next char
    pagesel		Gain238ValueT
    goto		Gain238ValueT
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
