matthew-wolf-n4mtt/audio-switch/firmware/mark-4_1/DisLPF.asm

; DisLPF.asm
; Version: 4.1
; Author:  Matthew J. Wolf
; Date:    31-MAY-2016, Info added 16-SEP-2019
;  
; This file is part of the Audio-Switch-MK4.
; By Matthew J. Wolf <matthew.wolf@speciosus.net>
; Copyright 2019 Matthew J. Wolf
;
; The Audio-Switch is distributed in the hope that
; it will be useful, but WITHOUT ANY WARRANTY; without even the implied
; warranty of MERCHANTABILITY or FITNESS FOR A PARTICULAR PURPOSE.  See
; the GNU General Public License for more details.
;
; You should have received a copy of the GNU General Public License
; along with the Audio-Switch-MK4.
; If not, see <http://www.gnu.org/licenses/>.
;
    title		'DisLPF - Display LPF lines LCD display'
    subtitle	''
    list		b=4,c=132,n=77,x=Off

; ------------------------------------------------------------------------
;**
;  DisLCD
;  Displayes line on the LCD.
;
;  Uses the LCDlib from the Elmer 160.
;**
;
; N4MTT - 23-March-2016
; $Revision 1.0	$Date: 2016-03-26 01441:00 $


    include		p16f1938.inc
			;include		p16f1933.inc

    global		DisLPF,SerMessCommLPF
    extern		LCDletr,SerialSendChar


    udata
LPFCharIdx	res			1		; Counter for name char index
LPFIdx		res			1

.DisLPF			code

DisLPF
    banksel		LPFIdx
    movwf		LPFIdx
    clrf		LPFCharIdx

DisLPFS
    bcf			STATUS,Z		; Reset Status reg
    pagesel		LPF0Freq
    movf		LPFIdx,W
    xorlw		H'00'
    btfsc		STATUS,Z		 ;Was it Zero?
    goto		LPF0FreqT
    pagesel		LPF1FreqT
    movf		LPFIdx,W
    xorlw		H'01'
    btfsc		STATUS,Z		 ;Was it Zero?
    goto		LPF1FreqT
    pagesel		LPF2FreqT
    movf		LPFIdx,W
    xorlw		H'02'
    btfsc		STATUS,Z		 ;Was it Zero?
    goto		LPF2FreqT
    pagesel		LPF3FreqT
    movf		LPFIdx,W
    xorlw		H'03'
    btfsc		STATUS,Z		 ;Was it Zero?
    goto		LPF3FreqT
    pagesel		LPF4FreqT
    movf		LPFIdx,W
    xorlw		H'04'
    btfsc		STATUS,Z		 ;Was it Zero?
    goto		LPF4FreqT
    pagesel		LPF5FreqT
    movf		LPFIdx,W
    xorlw		H'05'
    btfsc		STATUS,Z		 ;Was it Zero?
    goto		LPF5FreqT
    pagesel		LPF6FreqT
    movf		LPFIdx,W
    xorlw		H'06'
    btfsc		STATUS,Z		 ;Was it Zero?
    goto		LPF6FreqT
    pagesel		LPF7FreqT
    movf		LPFIdx,W
    xorlw		H'07'
    btfsc		STATUS,Z		 ;Was it Zero?
    goto		LPF7FreqT
    pagesel		LPF8FreqT
    movf		LPFIdx,W
    xorlw		H'08'
    btfsc		STATUS,Z		 ;Was it Zero?
    goto		LPF8FreqT
    pagesel		LPF9FreqT
    movf		LPFIdx,W
    xorlw		H'09'
    btfsc		STATUS,Z		 ;Was it Zero?
    goto		LPF9FreqT
    pagesel		LPF10FreqT
    movf		LPFIdx,W
    xorlw		H'0A'
    btfsc		STATUS,Z		 ;Was it Zero?
    goto		LPF10FreqT
    pagesel		LPF11FreqT
    movf		LPFIdx,W
    xorlw		H'0B'
    btfsc		STATUS,Z		 ;Was it Zero?
    goto		LPF11FreqT
    pagesel		LPF12FreqT
    movf		LPFIdx,W
    xorlw		H'0C'
    btfsc		STATUS,Z		 ;Was it Zero?
    goto		LPF12FreqT
    pagesel		LPF13FreqT
    movf		LPFIdx,W
    xorlw		H'0D'
    btfsc		STATUS,Z		 ;Was it Zero?
    goto		LPF13FreqT
    pagesel		LPF14FreqT
    movf		LPFIdx,W
    xorlw		H'0E'
    btfsc		STATUS,Z		 ;Was it Zero?
    goto		LPF14FreqT
    pagesel		LPF15FreqT
    movf		LPFIdx,W
    xorlw		H'0F'
    btfsc		STATUS,Z		 ;Was it Zero?
    goto		LPF15FreqT
    pagesel		LPF16FreqT
    movf		LPFIdx,W
    xorlw		H'10'
    btfsc		STATUS,Z		 ;Was it Zero?
    goto		LPF16FreqT
    pagesel		LPF17FreqT
    movf		LPFIdx,W
    xorlw		H'11'
    btfsc		STATUS,Z		 ;Was it Zero?
    goto		LPF17FreqT
    pagesel		LPF18FreqT
    movf		LPFIdx,W
    xorlw		H'12'
    btfsc		STATUS,Z		 ;Was it Zero?
    goto		LPF18FreqT
    pagesel		LPF19FreqT
    movf		LPFIdx,W
    xorlw		H'13'
    btfsc		STATUS,Z		 ;Was it Zero?
    goto		LPF19FreqT
    pagesel		LPF20FreqT
    movf		LPFIdx,W
    xorlw		H'14'
    btfsc		STATUS,Z		 ;Was it Zero?
    goto		LPF20FreqT
    pagesel		LPF21FreqT
    movf		LPFIdx,W
    xorlw		H'15'
    btfsc		STATUS,Z		 ;Was it Zero?
    goto		LPF21FreqT
    pagesel		LPF22FreqT
    movf		LPFIdx,W
    xorlw		H'16'
    btfsc		STATUS,Z		 ;Was it Zero?
    goto		LPF22FreqT
    pagesel		LPF23FreqT
    movf		LPFIdx,W
    xorlw		H'17'
    btfsc		STATUS,Z		 ;Was it Zero?
    goto		LPF23FreqT
    pagesel		LPF24FreqT
    movf		LPFIdx,W
    xorlw		H'18'
    btfsc		STATUS,Z		 ;Was it Zero?
    goto		LPF24FreqT
    pagesel		LPF25FreqT
    movf		LPFIdx,W
    xorlw		H'19'
    btfsc		STATUS,Z		 ;Was it Zero?
    goto		LPF25FreqT
    pagesel		LPF26FreqT
    movf		LPFIdx,W
    xorlw		H'1A'
    btfsc		STATUS,Z		 ;Was it Zero?
    goto		LPF26FreqT
    pagesel		LPF27FreqT
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
    banksel		LPFCharIdx
    clrf		LPFCharIdx
	
    bcf			STATUS,Z
    pagesel		SerMessCommLPFT
    call 		SerMessCommLPFT	; Get Port Name Char
    xorlw		H'00'		; Test to see if char is Zero
    btfsc		STATUS,Z	; Was it Zero?
    return

    pagesel		SerialSendChar
    call		SerialSendChar

    banksel		LPFCharIdx
    incf		LPFCharIdx,F
    goto		SerMessCommLPF
    
SerMessCommLPFT
    ;banksel		CharIdx
    movf		LPFCharIdx,W
    pagesel		SerMessCommLPFTs
    call		SerMessCommLPFTs
    xorlw		H'00'		; Test to see if char is Zero
    btfsc		STATUS,Z	; Was it Zero?
    return
    pagesel		SerialSendChar
    call		SerialSendChar	; Send Chr
    banksel		LPFCharIdx
    incf		LPFCharIdx,F	; Point to the next char
    pagesel		SerMessCommLPFT
    goto 		SerMessCommLPFT
    
SerMessCommLPFTs
    brw
    dt			"Low Pass Filter ",0       

		        end
