matthew-wolf-n4mtt/audio-switch/(commit log)

2019-09-16 added schematic diagrams
2019-09-16 corrected the mark-2b schematic
2019-09-16 Added gerbers and firmware
2019-09-16 Corrections for firmware and hardware
    [Audio-Switch.asm, DisGain.asm, DisLPF.asm, Display.asm, MyInit.asm, Myletr.asm, mySnd.asm]
2019-09-17 Added the tools I created
    [DAC-stuff.ods, Pot-vol-drop.ods, Pot-vol-out.ods]
2019-09-17 Moved the hw tools from the fw dir
    [DAC-stuff.ods, Pot-vol-drop.ods, Pot-vol-out.ods]
